andrewsargent2311-web/Engine_meter/Photos/20261017_170301.jpg

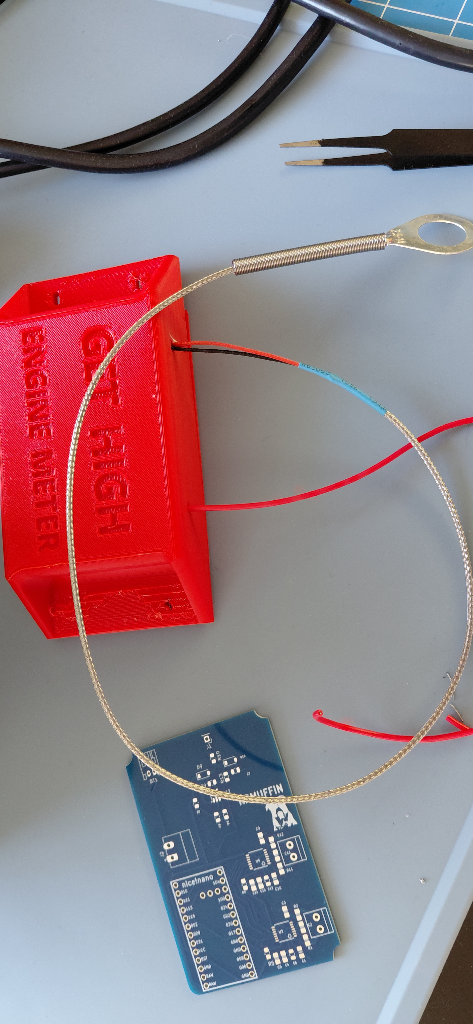
Photos/20261017_170301.jpg
