andrewsargent2311-web/Engine_meter/Engine_monitor_V1/Engine_monitor_V1_bom.csv

Reference | Qty | Value | DNP | Exclude from BOM | Exclude from Board | Footprint | Datasheet
C1,C10 | 2 | 0.01uF |  |  |  | Adafruit MAX31856:0805_10MGAP
C2,C4,C5,C11,C12,C14 | 6 | 0.1uF |  |  |  | Adafruit MAX31856:0805-NO
C3,C9 | 2 | 0.01uF |  |  |  | Adafruit MAX31856:0805-NO
C6,C13 | 2 | 10u |  |  |  | Capacitor_SMD:C_0805_2012Metric
C8 | 1 | 100nF |  |  |  | Capacitor_SMD:C_0805_2012Metric
D9,D10 | 2 | D_Schottky |  |  |  | Diode_SMD:D_SOD-123
R1,R2,R11,R12 | 4 | 100 |  |  |  | Adafruit MAX31856:0805-NO
R4,R5 | 2 | 10K |  |  |  | Resistor_SMD:R_0805_2012Metric_Pad1.20x1.40mm_HandSolder
R7,R8,R9 | 3 | 10k |  |  |  | Resistor_SMD:R_0805_2012Metric
R10 | 1 | 150k |  |  |  | Resistor_SMD:R_0805_2012Metric
R13 | 1 | 1M |  |  |  | Resistor_SMD:R_0805_2012Metric
R14 | 1 | 220k |  |  |  | Resistor_SMD:R_0805_2012Metric
U2 | 1 | LMV331 |  |  |  | Package_TO_SOT_SMD:SOT-23-5 | http://www.ti.com/lit/ds/symlink/lmv331.pdf
U3,U4 | 2 | MAX31856 |  |  |  | Adafruit MAX31856:TSSOP14
