andrewsargent2311-web/Engine_meter/Engine_monitor_V1/Gerber files/Engine_monitor_V1_BOM_JLCPCB.xlsx

Comment | Designator | Footprint | LCSC Part #
10nF 50V X7R | C1,C3,C9,C10 | 0805
100nF 50V X7R | C2,C4,C5,C8,C11,C12,C14 | 0805
10uF 25V X5R | C6,C13 | 0805
100R 1% | R1,R2,R11,R12 | 0805
10k 1% | R4,R5,R7,R8,R9 | 0805
150k 1% (CHECK: PCB says 22k) | R10 | 0805
1M 1% | R13 | 0805
220k 1% | R14 | 0805
1N5819HW-7-F (consigned) | D9,D10 | SOD-123
LMV331IDBVR | U2 | SOT-23-5
MAX31856MUD+ | U3,U4 | TSSOP-14
