andrewsargent2311-web/Engine_meter/Engine_monitor_V1/Gerber files/Engine_monitor_V1_BOM.xlsx

Item # | Designator | Qty | Value / Description | Package / Footprint | Manufacturer | Manufacturer Part # | Type | Notes
1 | C1,C3,C9,C10 | 4 | 10nF, 50V, X7R, ±10% | 0805 | Samsung | CL21B103KBANNNC | SMD | MAX31856 filter caps
2 | C2,C4,C5,C8,C11,C12,C14 | 7 | 100nF, 50V, X7R, ±10% | 0805 | Samsung | CL21B104KBCNNNC | SMD | 0.1uF = 100nF, merged
3 | C6,C13 | 2 | 10uF, 25V, X5R, ±10% | 0805 | Samsung | CL21A106KAYNNNE | SMD
4 | R1,R2,R11,R12 | 4 | 100R, 1%, 1/8W | 0805 | Yageo | RC0805FR-07100RL | SMD
5 | R4,R5,R7,R8,R9 | 5 | 10k, 1%, 1/8W | 0805 | Yageo | RC0805FR-0710KL | SMD | R4/R5 '10K' and R7-R9 '10k' merged
6 | R10 | 1 | 150k, 1%, 1/8W | 0805 | Yageo | RC0805FR-07150KL | SMD
7 | R13 | 1 | 1M, 1%, 1/8W | 0805 | Yageo | RC0805FR-071ML | SMD
8 | R14 | 1 | 220k, 1%, 1/8W | 0805 | Yageo | RC0805FR-07220KL | SMD
9 | D9,D10 | 2 | 1N5819HW-7-F, Schottky, 40V 1A | SOD-123 | Diodes Inc. | 1N5819HW-7-F | SMD
10 | U2 | 1 | LMV331 single comparator | SOT-23-5 | Texas Instruments | LMV331IDBVR | SMD
11 | U3,U4 | 2 | MAX31856 thermocouple-to-digital converter | TSSOP-14 | Analog Devices (Maxim) | MAX31856MUD+ | SMD
