andrewsargent2311-web/Engine_meter/3D print files/Engine meter lid.stl

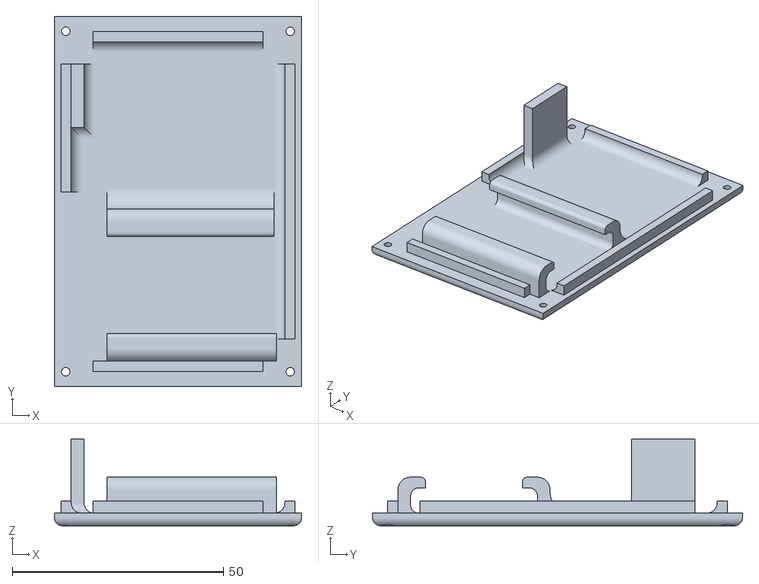
[picture p5: CAD file, 2026-10-22]
3D print files/Engine meter lid.stl
58.5 x 87.5 x 20.5
