andrewsargent2311-web/Engine_meter/3D print files/Engine meter case.stl

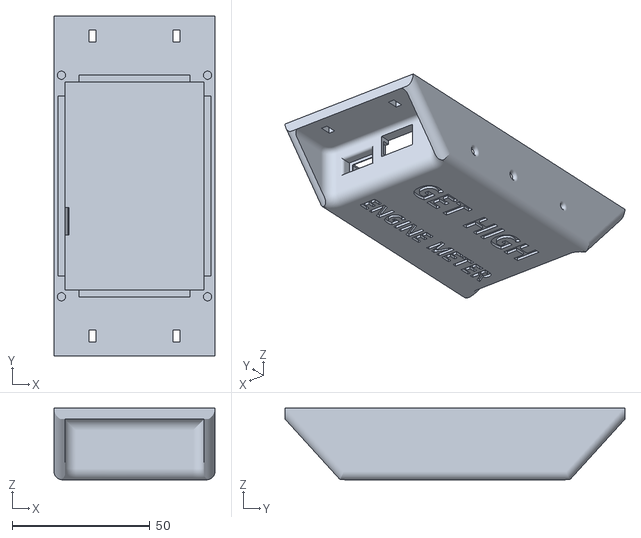
[picture p6: CAD file, 2026-10-17]
3D print files/Engine meter case.stl
58.5 x 123.5 x 26.0
