andrewsargent2311-web/Engine_meter/Engine_monitor_V1/Engine_monitor_V1.kicad_pcb

## KiCad design Engine_monitor_V1/Engine_monitor_V1.kicad_pcb (2026-10-16)

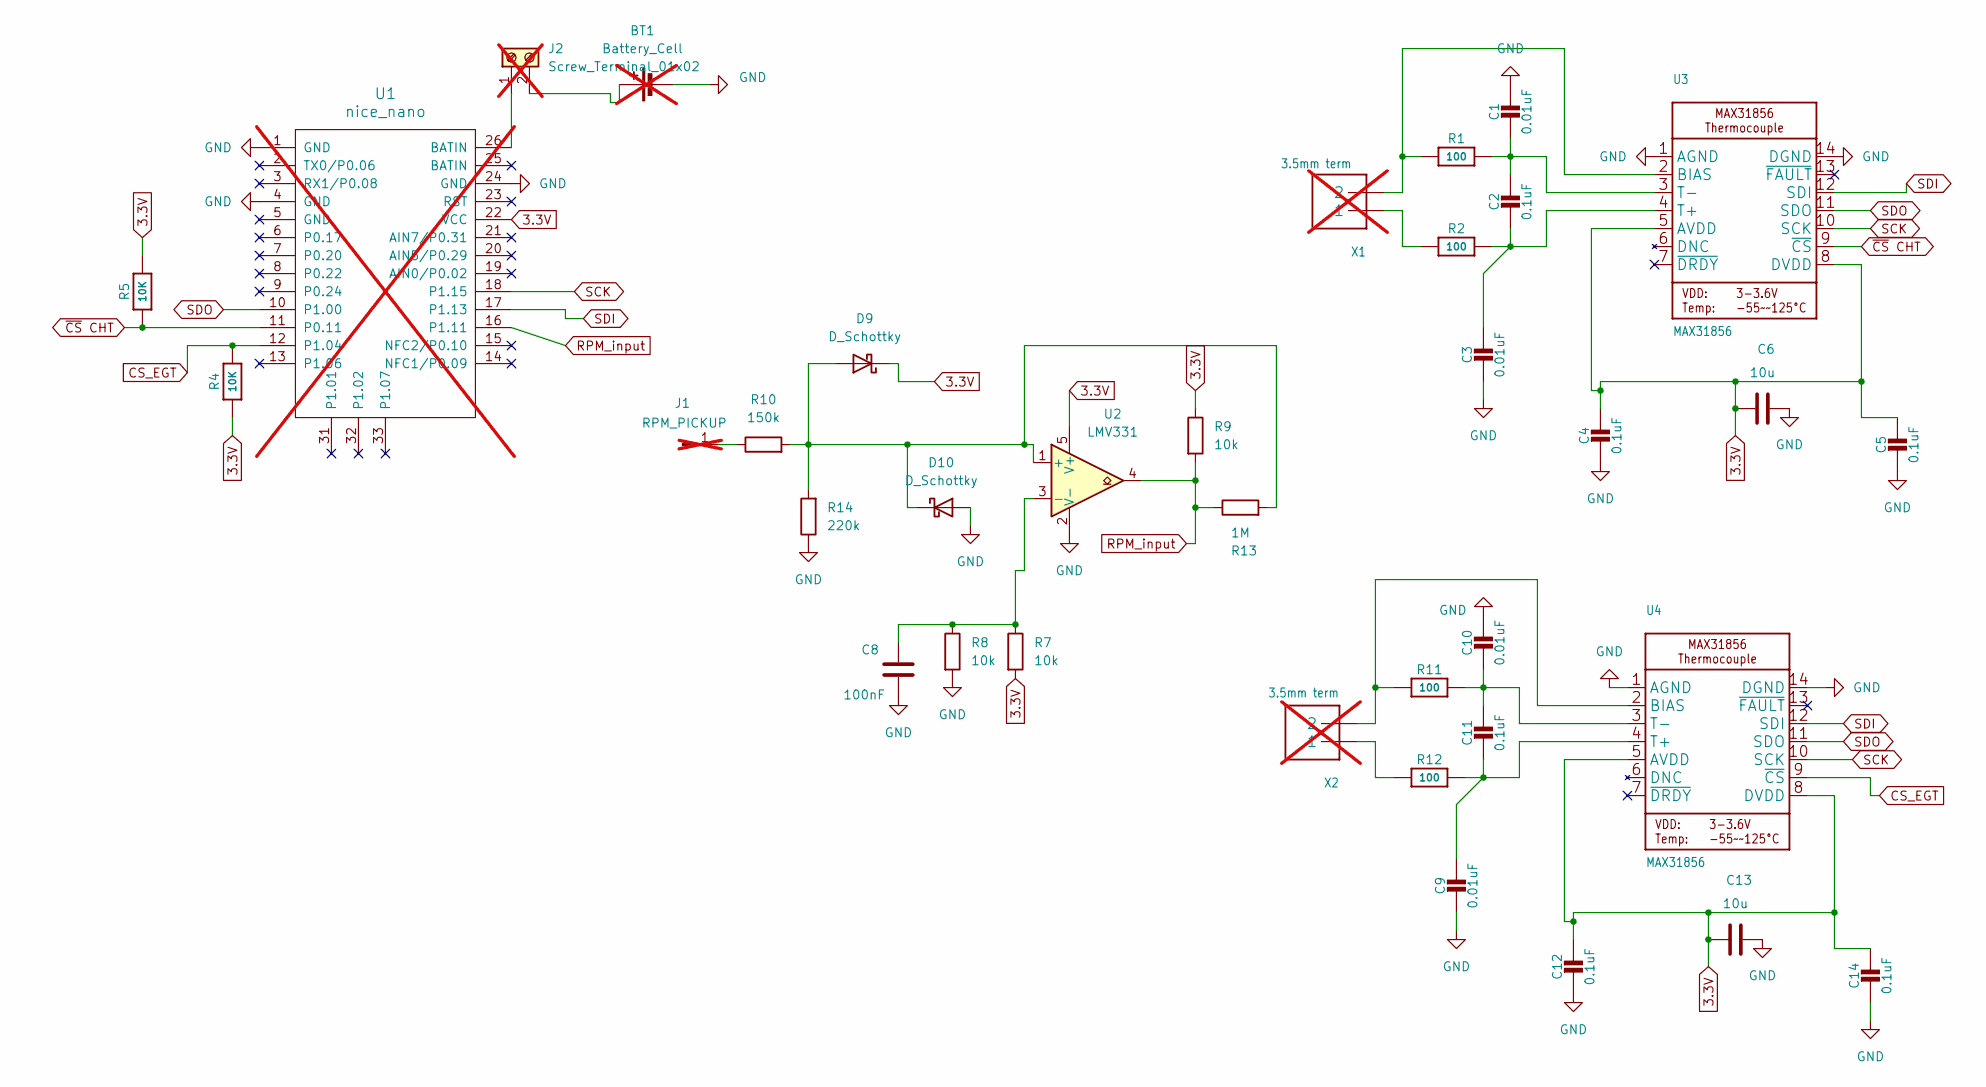
[picture p7: schematic Engine_monitor_V1.kicad_sch]

Parts:
BT1: Battery_Cell; JST_PH_S2B-PH-K_1x02_P2.00mm_Horizontal; not fitted
C1, C10: 0.01uF; 0805_10MGAP
C2, C4, C5, C11, C12, C14: 0.1uF; 0805-NO
C3, C9: 0.01uF; 0805-NO
C6, C13: 10u; C_0805_2012Metric
C8: 100nF; C_0805_2012Metric
D9, D10: D_Schottky; D_SOD-123
J1: RPM_PICKUP; PinHeader_1x01_P2.54mm_Vertical; not fitted
J2: Screw_Terminal_01x02; PhoenixContact_MC_1,5_2-G-3.81_1x02_P3.81mm_Horizontal; not fitted
R1, R2, R11, R12: 100; 0805-NO
R4, R5: 10K; R_0805_2012Metric_Pad1.20x1.40mm_HandSolder
R7, R8, R9: 10k; R_0805_2012Metric
R10: 150k; R_0805_2012Metric
R13: 1M; R_0805_2012Metric
R14: 220k; R_0805_2012Metric
U1: nice_nano; not fitted
U2: LMV331; SOT-23-5
U3, U4: MAX31856; TSSOP14
X1, X2: 3.5mm term; TERMBLOCK_1X2-3.5MM; not fitted

Connections:
3.3V: C4.1, C5.1, C6.2, C12.1, C13.2, C14.1, D9.1 (K), R4.1, R5.2, R7.2, R9.1, U1.22 (VCC), U2.5 (V+), U3.5 (AVDD), U3.8 (DVDD), U4.5 (AVDD), U4.8 (DVDD)
CS_EGT: R4.2, U1.12 (P1.04), U4.9 (~CS)
GND: BT1.2 (-), C1.1, C3.2, C4.2, C5.2, C6.1, C8.2, C9.2, C10.1, C12.2, C13.1, C14.2, D10.2 (A), R8.2, R14.1, U1.1 (GND), U1.4 (GND), U1.24 (GND), U2.2 (V-), U3.1 (AGND), U3.14 (DGND), U4.1 (AGND), U4.14 (DGND)
unnamed: BT1.1 (+), J2.2
unnamed: D9.2 (A), D10.1 (K), R10.2, R13.2, R14.2, U2.1 (+)
unnamed: J1.1 (Pin_1_1), R10.1
unnamed: J2.1, U1.26 (BATIN)
unnamed: R2.1, X1.1
unnamed: R12.1, X2.1
unnamed: C8.1, R7.1, R8.1, U2.3 (-)
unnamed: R1.1, U3.2 (BIAS), X1.2
unnamed: C2.2, C3.1, R2.2, U3.4 (T+)
unnamed: C1.2, C2.1, R1.2, U3.3 (T-)
unnamed: R11.1, U4.2 (BIAS), X2.2
unnamed: C9.1, C11.2, R12.2, U4.4 (T+)
unnamed: C10.2, C11.1, R11.2, U4.3 (T-)
RPM_input: R9.2, R13.1, U1.16 (P1.11), U2.4
SCK: U1.18 (P1.15), U3.10 (SCK), U4.10 (SCK)
SDI: U1.17 (P1.13), U3.12 (SDI), U4.12 (SDI)
SDO: U1.10 (P1.00), U3.11 (SDO), U4.11 (SDO)
~CS CHT: R5.1, U1.11 (P0.11), U3.9 (~CS)

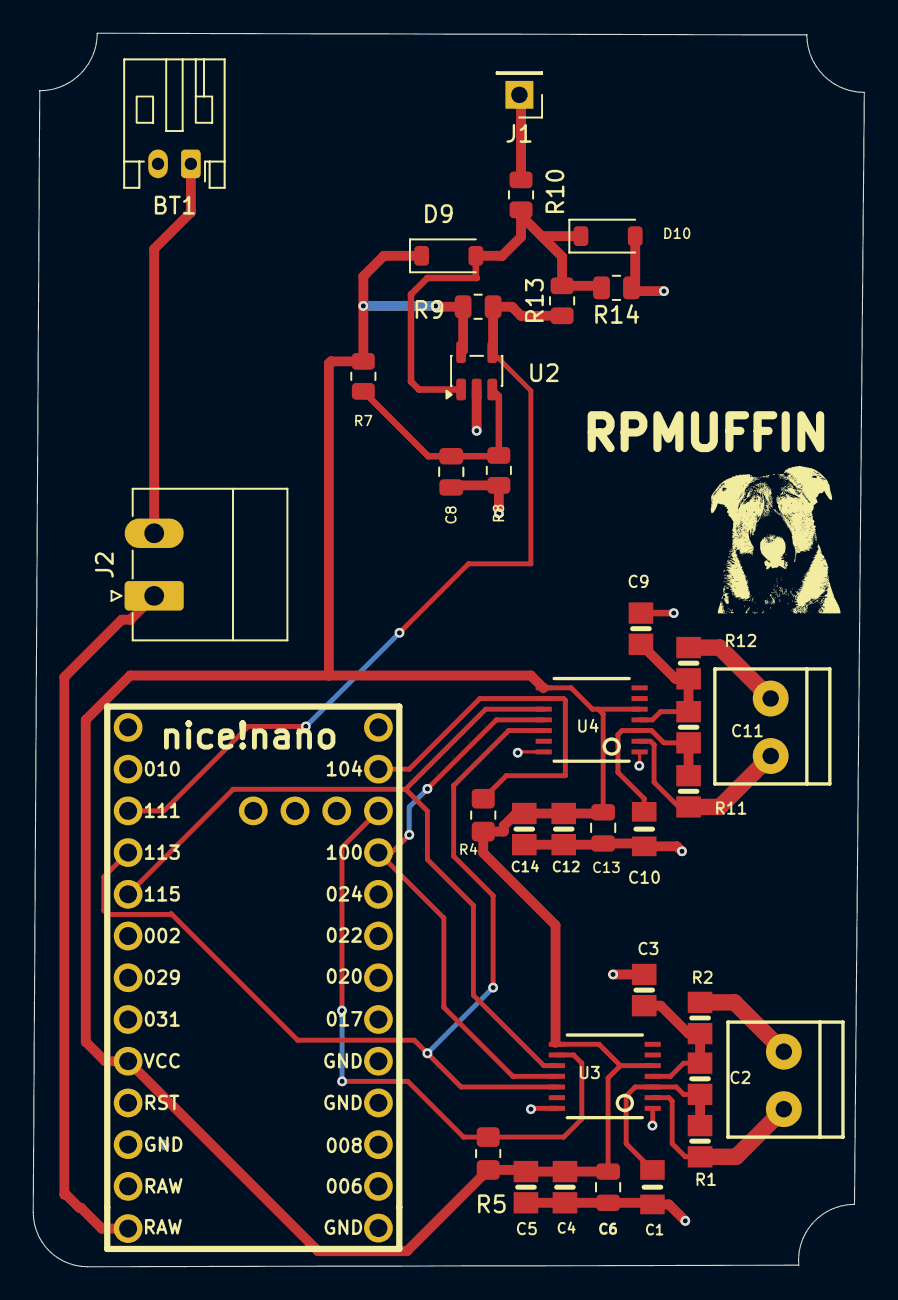
[picture p8: board Engine_monitor_V1/Engine_monitor_V1.kicad_pcb from above]

Board: 2 copper layers, 50.6 x 75.1 mm, 36 parts (0 on the bottom side), 21 nets.
