andrewsargent2311-web/Engine_meter/Engine_monitor_V1/_restore_backup_2026-09-02T17-29-26-343/Engine_monitor_V1.kicad_pcb

## KiCad design Engine_monitor_V1/_restore_backup_2026-09-02T17-29-26-343/Engine_monitor_V1.kicad_pcb (2026-09-14)

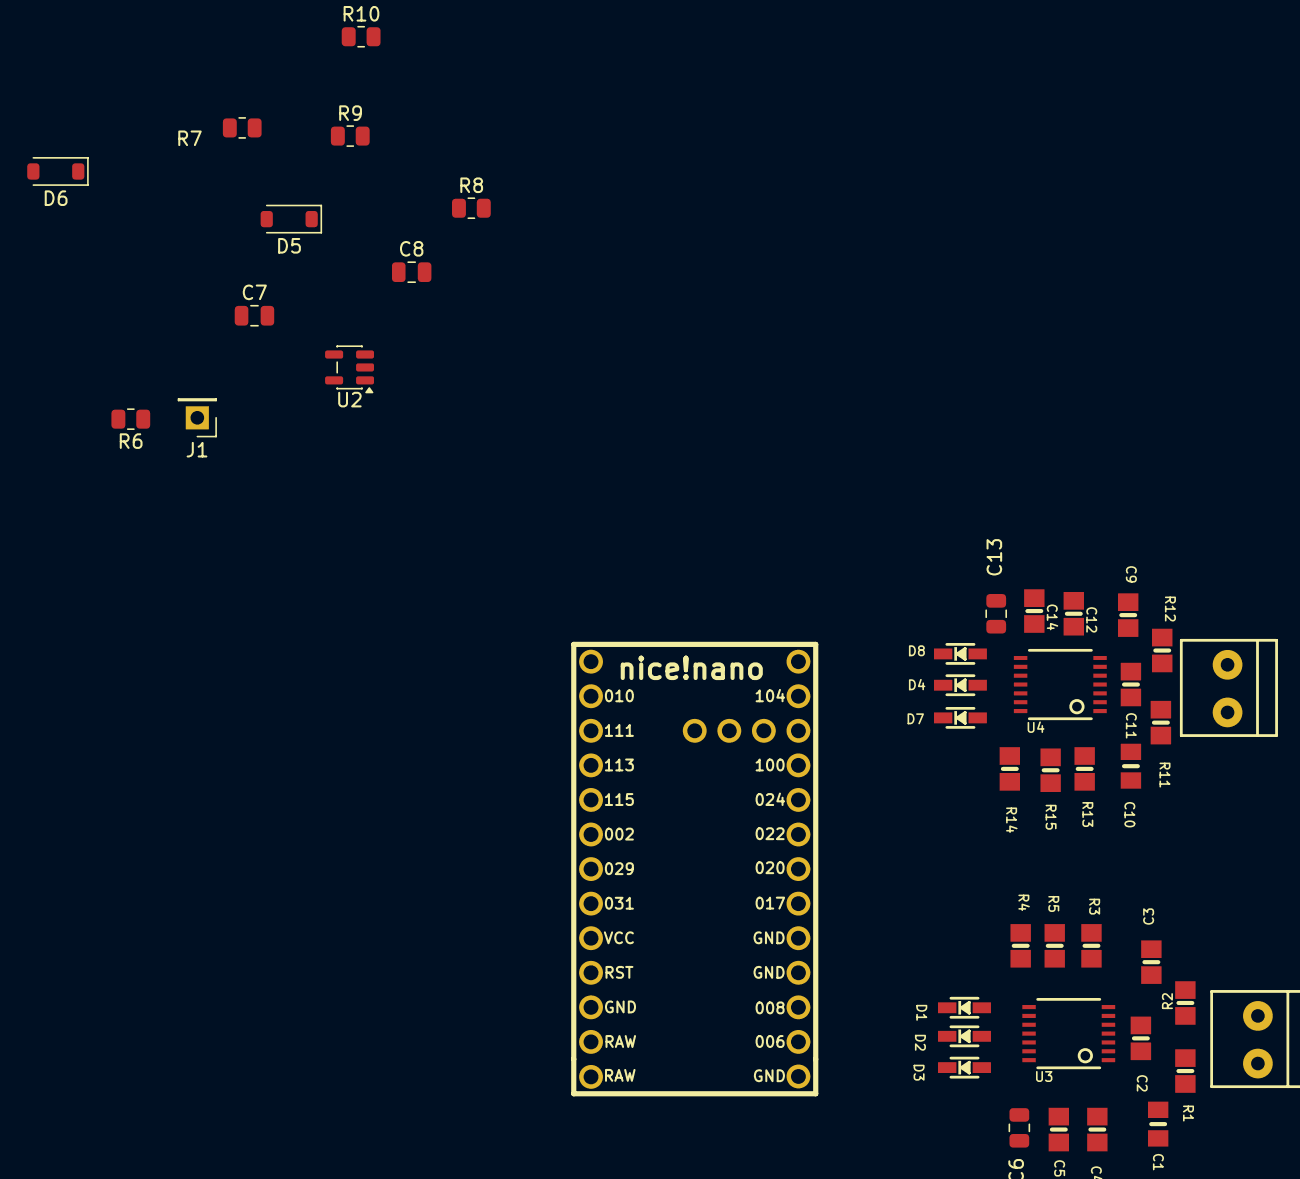
[picture p9: board Engine_monitor_V1/_restore_backup_2026-09-02T17-29-26-343/Engine_moni… from above]

Board: 2 copper layers, 44 parts (0 on the bottom side), 22 nets, no tracks yet.

Parts:
C1, C10: 0.01uF; 0805_10MGAP
C2, C4, C5, C11, C12, C14: 0.1uF; 0805-NO
C3, C9: 0.01uF; 0805-NO
C6, C13: 10u; C_0805_2012Metric
C7: 10nF; C_0805_2012Metric
C8: 100nF; C_0805_2012Metric
D1, D2, D3, D4, D7, D8: 1N4148; SOD-323
D5, D6: BAT54W; D_SOD-123
J1: RPM_PICKUP; PinHeader_1x01_P2.54mm_Vertical
R1, R2, R11, R12: 100; 0805-NO
R3, R4, R5, R13, R14, R15: 10K; 0805-NO
R6: 22k; R_0805_2012Metric
R7, R8, R9: 10k; R_0805_2012Metric
R10: 1M; R_0805_2012Metric
U1: nice_nano
U2: LMV331; SOT-23-5
U3, U4: MAX31856; TSSOP14
X1, X2: 3.5mm term; TERMBLOCK_1X2-3.5MM

Connections:
3.3V: C4.1, C5.1, C6.2, C12.1, C13.2, C14.1, R3.2, R4.2, R5.2, R7.2, R9.1, R13.2, R14.2, R15.2, U1.22 (VCC), U2.5 (V+), U3.5 (AVDD), U3.8 (DVDD), U4.5 (AVDD), U4.8 (DVDD)
CS_EGT: D8.C, U1.12 (P1.04)
GND: C1.1, C3.2, C4.2, C5.2, C6.1, C7.2, C8.2, C9.2, C10.1, C12.2, C13.1, C14.2, D6.1 (A_1), R8.2, U1.1 (GND), U1.4 (GND), U1.24 (GND), U2.2 (V-), U3.1 (AGND), U3.14 (DGND), U4.1 (AGND), U4.14 (DGND)
unnamed: C7.1, D5.1 (A_1), R6.2, R10.2, U2.1 (+)
unnamed: J1.1 (Pin_1_1), R6.1
unnamed: R2.1, X1.1
unnamed: R12.1, X2.1
unnamed: C8.1, R7.1, R8.1, U2.3 (-)
unnamed: D2.A, R4.1, U3.10 (SCK)
unnamed: D3.A, R3.1, U3.12 (SDI)
unnamed: D1.A, R5.1, U3.9 (~CS)
unnamed: D4.A, R14.1, U4.10 (SCK)
unnamed: D7.A, R13.1, U4.12 (SDI)
unnamed: D8.A, R15.1, U4.9 (~CS)
RPM_input: R9.2, R10.1, U1.16 (P1.11), U2.4
SCK: D2.C, D4.C, U1.8 (P0.22)
SDI: D3.C, D7.C, U1.9 (P0.24)
SDO: U1.10 (P1.00), U3.11 (SDO), U4.11 (SDO)
T+: C2.2, C3.1, C9.1, C11.2, R2.2, R12.2, U3.4 (T+), U4.4 (T+)
T-: C1.2, C2.1, C10.2, C11.1, R1.2, R11.2, U3.3 (T-), U4.3 (T-)
THERM-: R1.1, R11.1, U3.2 (BIAS), U4.2 (BIAS), X1.2, X2.2
~CS CHT: D1.C, U1.11 (P0.11)
