andrewsargent2311-web/Engine_meter/(commit log)

2026-09-14 PCB files added
2026-10-14 added battery monitor
2026-10-15 Update the schematic
    RPM meter isn't working, swapped a cap for a resistor.
2026-10-16 3D print file
2026-10-16 Battery readout fixed
2026-10-16 Added lid to case
2026-10-17 Updated stl files
2026-10-22 Added tab to hold PCB on the case
